SlenderN679/EP-CC_CC_Eolica/EP-CC_CC_Eólica/EP-CC_CC_Eólica.png

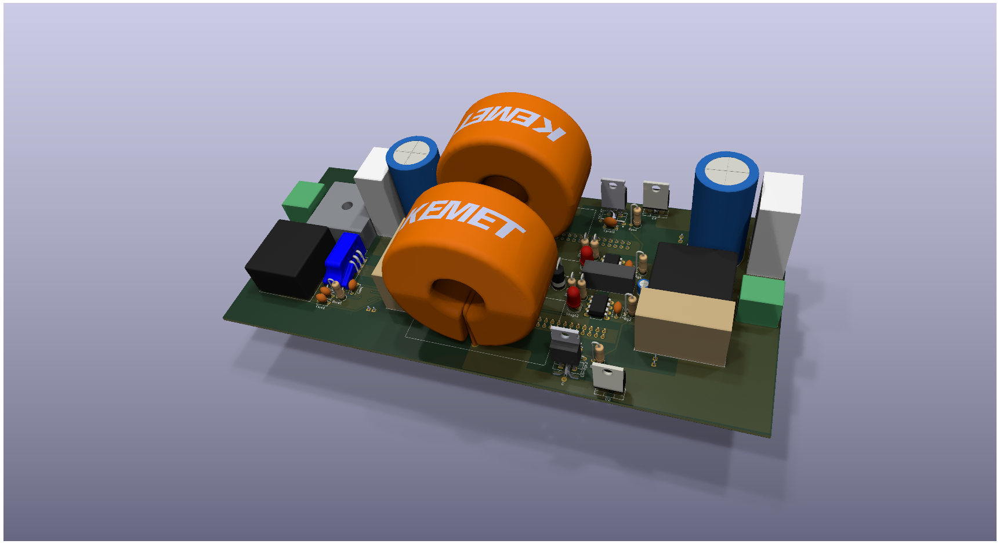
EP-CC_CC_Eólica/EP-CC_CC_Eólica.png
