SlenderN679/EP-CC_CC_Eolica/Lista_de_Componentes.xlsx

Reference | Value | Qty
Condensador eletrolítico pot. | 470uF 200V | 2
Condensador de filme pot. | 1.5uF 1.3KVDC | 2
Condensador eletrolítico | 1uF | 1
Condensador de ceramica | 47nF / 0.1uF / 10n | 7
Ponte retificadora trifásica | 600V 35A | 1
Díodo de potência | C3D10060A | 2
Leds de sinalização | 1.8V | 2
Díodo de Zener | 15 | 3
Conector | Lever Terminal Block | 3
Indutores | 311uH 15A | 2
Optocouplers | HCPL-3120 | 2
IGBT | 600V40A | 2
Resistências | 22 / 10k / 180 / 330 | 9
Resistências de descarga | 4.7k | 2
Sensor de corrente | HE/OL 25A | 1
STM32 | ~ | 1
Sensor de tensão | LV25-P | 2
Conversor CC-CC isolado | MEV1S1515SC | 1
