SlenderN679/EP-CC_CC_Eolica/EP-CC_CC_Eólica.csv

Reference | Qty | Value | Footprint | Datasheet
C1,C3 | 2 | 470uF 200V | Boost:CAP_22 X 35_NCH | LGU2D471MELZ
C2 | 1 | 1.5uF 1.3KVDC | Boost:CAP_B32774D1155K000_TDK | https://www.tdk-electronics.tdk.com/inf/20/20/db/fc_2009/MKP_B32774_778.pdf
C4 | 1 | 1.5UF 1.3KVDC | Boost:CAP_B32774D1155K000_TDK | https://www.tdk-electronics.tdk.com/inf/20/20/db/fc_2009/MKP_B32774_778.pdf
Cdc1 | 1 | 1uF | Capacitor_THT:CP_Radial_D5.0mm_P2.00mm | https://www.digikey.pt/en/products/detail/w%C3%BCrth-elektronik/860020672005/5727088
Cfilt1,Cref1,Cvcc1 | 3 | 47nF - Cer | Capacitor_THT:C_Disc_D5.1mm_W3.2mm_P5.00mm | https://www.digikey.pt/en/products/detail/kemet/C320C104K5R5TA/818040
Chcpl1,Chcpl2 | 2 | 0.1uF - Cer | Capacitor_THT:C_Disc_D5.1mm_W3.2mm_P5.00mm | https://www.digikey.pt/en/products/detail/kemet/C320C104K5R5TA/818040
Cprot1,Cprot2 | 2 | 10n | Capacitor_THT:C_Disc_D6.0mm_W2.5mm_P5.00mm
D1 | 1 | 600V 35A | Boost:VS-36MT160 | https://www.vishay.com/docs/93565/vs-36mtseries.pdf
D2,D3 | 2 | C3D10060A | PCM_Package_TO_SOT_THT_AKL:TO-220-2_Vertical_KA | https://www.tme.eu/Document/ee20f02f8d854de81dced643903ee11c/C3D08060A.pdf
Dhcpl1,Dhcpl2 | 2 | 1.8V | LED_THT:LED_D5.0mm | https://www.digikey.pt/en/products/detail/liteon/LTL2R3KRD-EM/2675133
DZ1 | 1 | D_Zener_Generic | Diode_THT:D_DO-27_P5.08mm_Vertical_AnodeUp | ~
DZprot1,DZprot2 | 2 | 15 | Diode_THT:D_DO-34_SOD68_P10.16mm_Horizontal | ~
J1 | 1 | Screw_Terminal_01x03 | Connector_Phoenix_SPT:PhoenixContact_SPT_2.5_3-H-5.0-EX_1x03_P5.0mm_Horizontal | ~
J2 | 1 | Screw_Terminal_01x02 | Connector_Phoenix_SPT:PhoenixContact_SPT_2.5_2-H-5.0-EX_1x02_P5.0mm_Horizontal | ~
JSource1 | 1 | Screw_Terminal_01x02 | Boost:CONN2_2604-3102_WAG | https://www.digikey.pt/en/products/detail/wago-corporation/2604-1101/15522416
L1,L2 | 2 | 311uH 15A | Boost:SHBC24W-2R1A0311V | https://yageogroup.com/content/datasheet/asset/file/KEM_LF0051_SHBC
OCiso1,OCiso2 | 2 | HCPL-3120 | PCM_Package_DIP_AKL:DIP-8_W7.62mm_LongPads | https://www.digikey.pt/en/products/detail/broadcom-limited/HCPL-3120/637386
Qbridge1,Qbridge2 | 2 | 600V40A | Boost:TO-220_High | https://www.tme.eu/Document/3d0f1152e66224fa282804db9c407ed3/STGW60V60DF.pdf
Rg1,Rg2 | 2 | 22 | Resistor_THT:R_Axial_DIN0309_L9.0mm_D3.2mm_P2.54mm_Vertical | https://www.digikey.pt/en/products/detail/stackpole-electronics-inc/CF14JT22R0/1741344
Rgs1,Rgs2,Rocd1 | 3 | 10k | Resistor_THT:R_Axial_DIN0309_L9.0mm_D3.2mm_P2.54mm_Vertical | https://www.digikey.pt/en/products/detail/stackpole-electronics-inc/CF12JT10K0/1741024,https://www.digikey.pt/en/products/detail/stackpole-electronics-inc/CFM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
Rhcpl1,Rhcpl2 | 2 | 180 | Resistor_THT:R_Axial_DIN0309_L9.0mm_D3.2mm_P2.54mm_Vertical | https://www.digikey.pt/en/products/detail/stackpole-electronics-inc/CF14JT180R/1741307
Rled1,Rled2 | 2 | 330 | Resistor_THT:R_Axial_DIN0309_L9.0mm_D3.2mm_P2.54mm_Vertical | https://www.digikey.pt/en/products/detail/stackpole-electronics-inc/CFM12JT330R/1741936
Rsafety1,Rsafety2 | 2 | 4.7k | Boost:TWM20J4K7E | https://www.ohmite.com/assets/images/res-tww-twm.pdf
S1 | 1 | HE/OL 25A | Boost:HO 25-N_SP33-1000 | https://www.lem.com/sites/default/files/products_datasheets/ho-np-sp33-1000-series-v7.pdf
STM1 | 1 | ~ | Boost:ST_Morpho_and_Zio_Connectors_144_STLink
U1,U2 | 2 | LV25-P | Sensor_Voltage:LEM_LV25-P | https://www.lem.com/sites/default/files/products_datasheets/lv_25-p.pdf
Upot1 | 1 | MEV1S1515SC | Library:MEV1S1505SC | https://www.digikey.pt/en/products/detail/murata-power-solutions-inc/MEV1S1515SC/2184911
