SlenderN679/EP-CC_CC_Eolica/EP-CC_CC_Eólica/Componentes/2604_3102 (1)/CadenasModel/2604-3102.igs

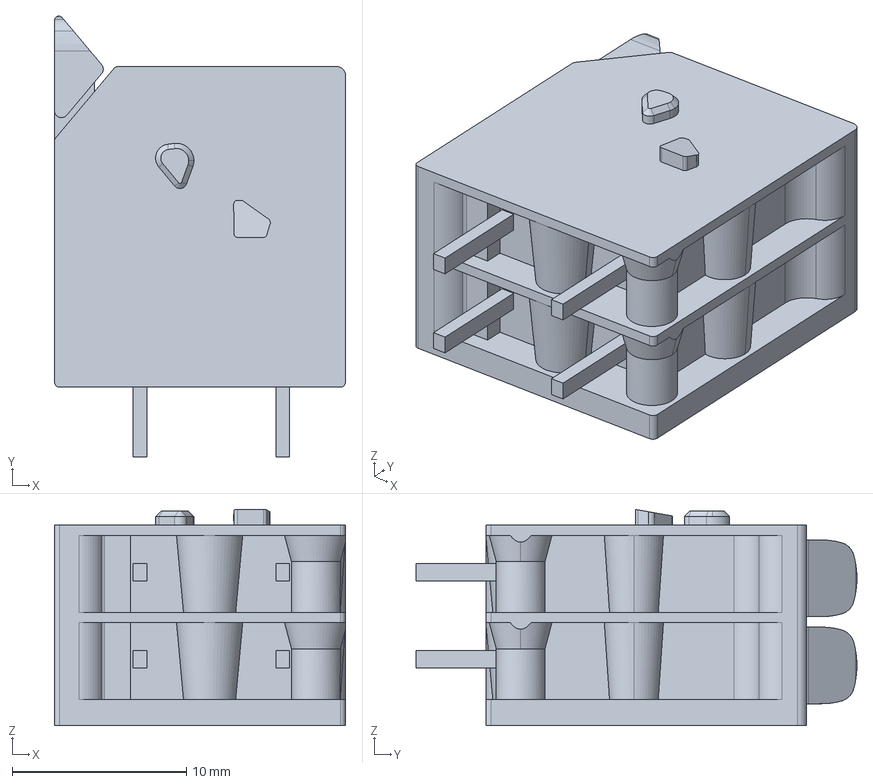
[picture p2: CAD file, 2026-10-19]
EP-CC_CC_Eólica/Componentes/2604_3102 (1)/CadenasModel/2604-3102.igs
16.7 x 25.3 x 12.4 mm
