SlenderN679/EP-CC_CC_Eolica/EP-CC_CC_Eólica/Componentes/64.50.19.033.0_20121120/HO_25-NP_SP33_blackbox/HO_25-NP_SP33_BLACKBOX.stp

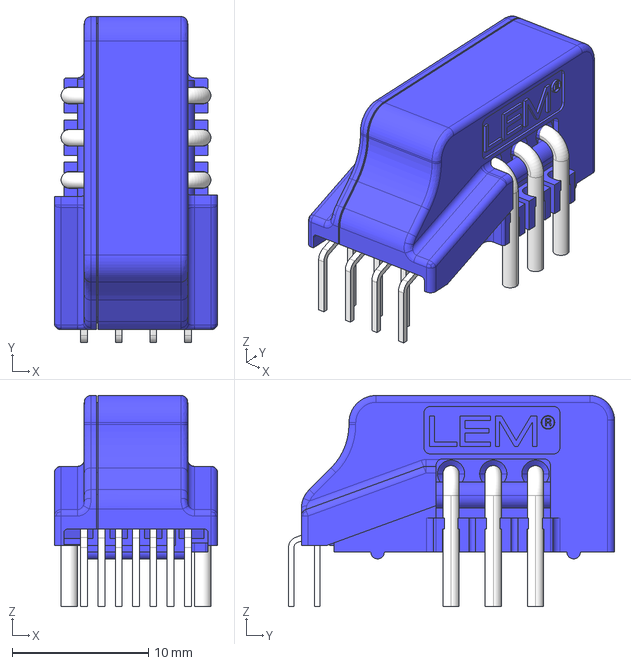
[picture p3: CAD file, 2026-10-19]
EP-CC_CC_Eólica/Componentes/64.50.19.033.0_20121120/HO_25-NP_SP33_blackbox/HO_25-NP_SP33_BLACKBOX.stp
12.0 x 23.9 x 15.5 mm
