SlenderN679/EP-CC_CC_Eolica/EP-CC_CC_Eólica/Componentes/90.27.19.000.0_20090128/LV25-P.stp

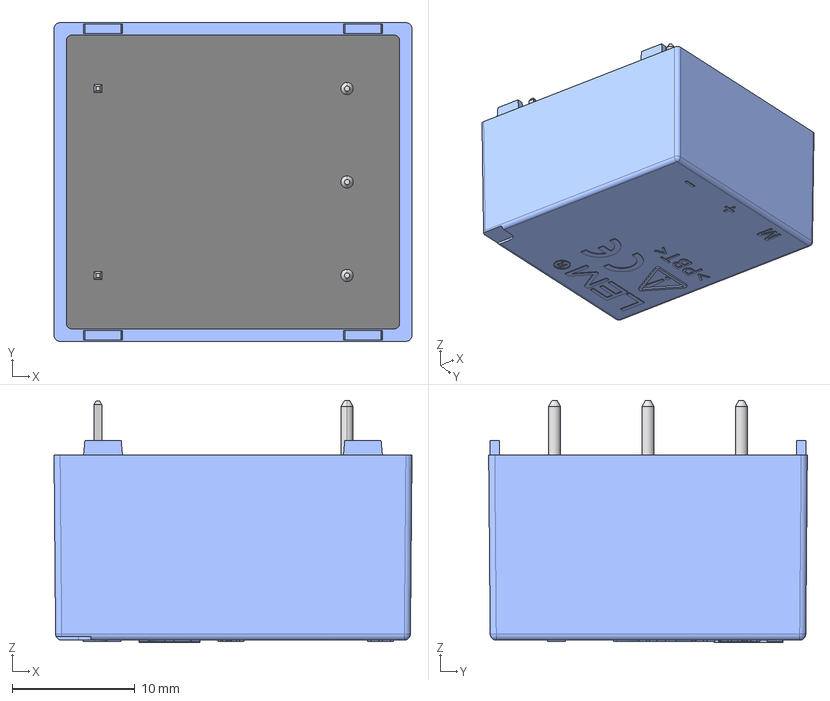
[picture p4: CAD file, 2026-09-29]
EP-CC_CC_Eólica/Componentes/90.27.19.000.0_20090128/LV25-P.stp
29.2 x 26.0 x 19.8 mm
boitier_blackbox
pin_mesure_Plus
pin_mesure_Moins
pin_mesure_M
pin_bobinage
pin_bobinage.1
moulage
