SlenderN679/EP-CC_CC_Eolica/EP-CC_CC_Eólica/Componentes/B32774D1155K000/CAP_B32774D1155K000_TDK.step

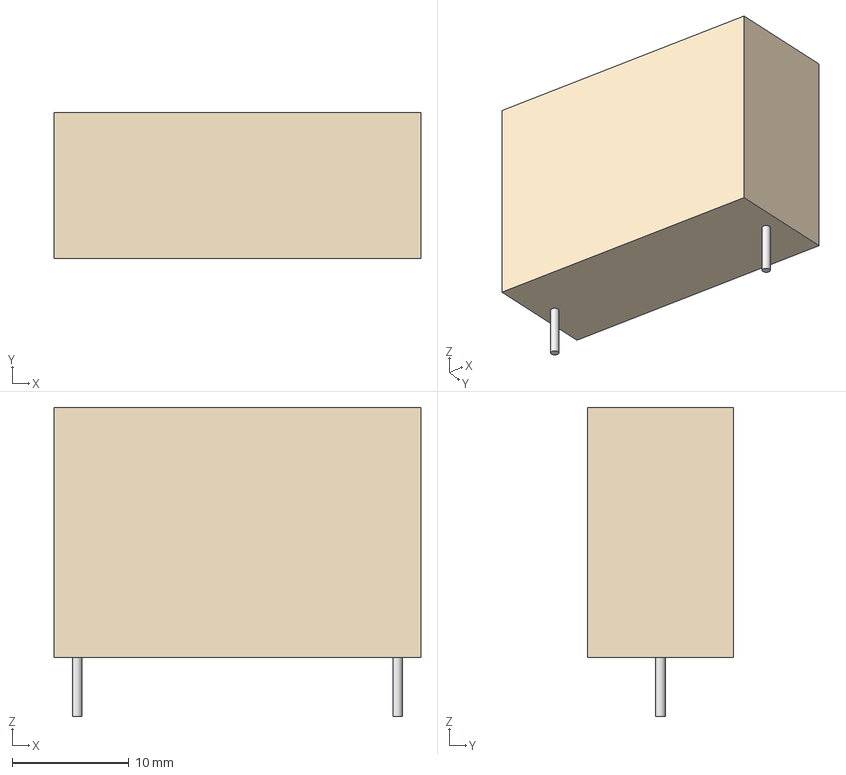
[picture p5: CAD file, 2026-09-29]
EP-CC_CC_Eólica/Componentes/B32774D1155K000/CAP_B32774D1155K000_TDK.step
31.5 x 12.5 x 26.5 mm
