SlenderN679/EP-CC_CC_Eolica/EP-CC_CC_Eólica/Componentes/C4D20120D/D Package Diode.step

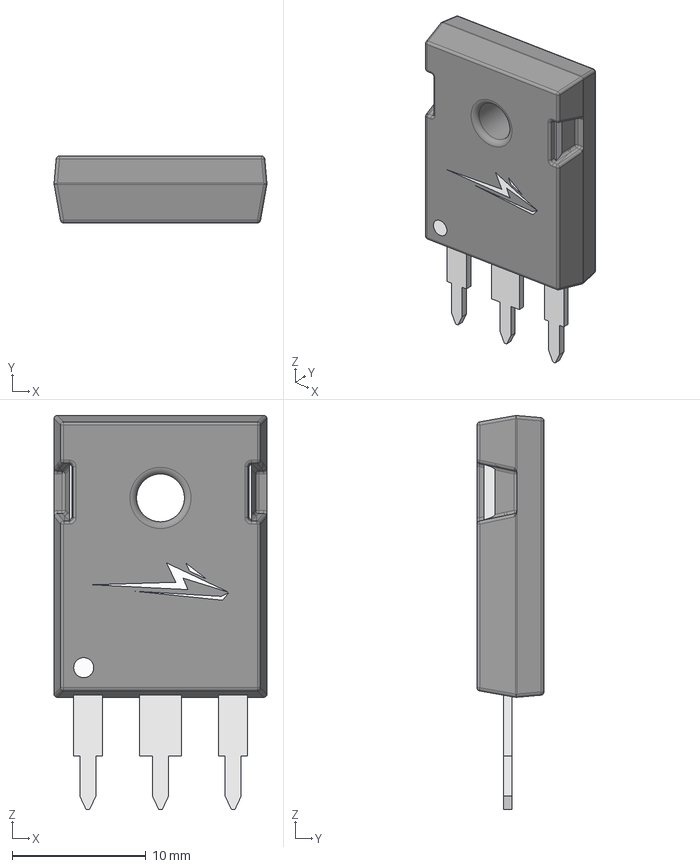
[picture p6: CAD file, 2026-09-29]
EP-CC_CC_Eólica/Componentes/C4D20120D/D Package Diode.step
15.9 x 5.02 x 29.5 mm
Pins
1.5mm
Wolfspeed Logo
Rear Tab
