SlenderN679/EP-CC_CC_Eolica/EP-CC_CC_Eólica/Componentes/IKW40N120H3FKSA1/PG-TO247-3-40.stp

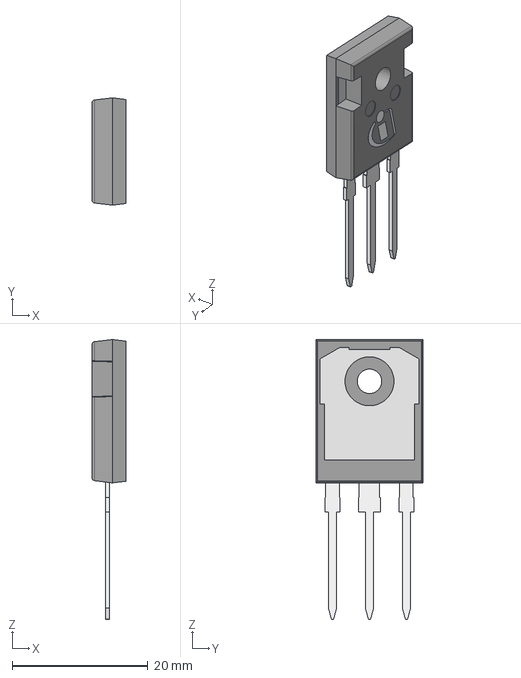
[picture p7: CAD file, 2026-09-29]
EP-CC_CC_Eólica/Componentes/IKW40N120H3FKSA1/PG-TO247-3-40.stp
5.01 x 15.8 x 41.2 mm
