SlenderN679/EP-CC_CC_Eolica/EP-CC_CC_Eólica/Componentes/PE_53117NL/PE-53117NL.STEP

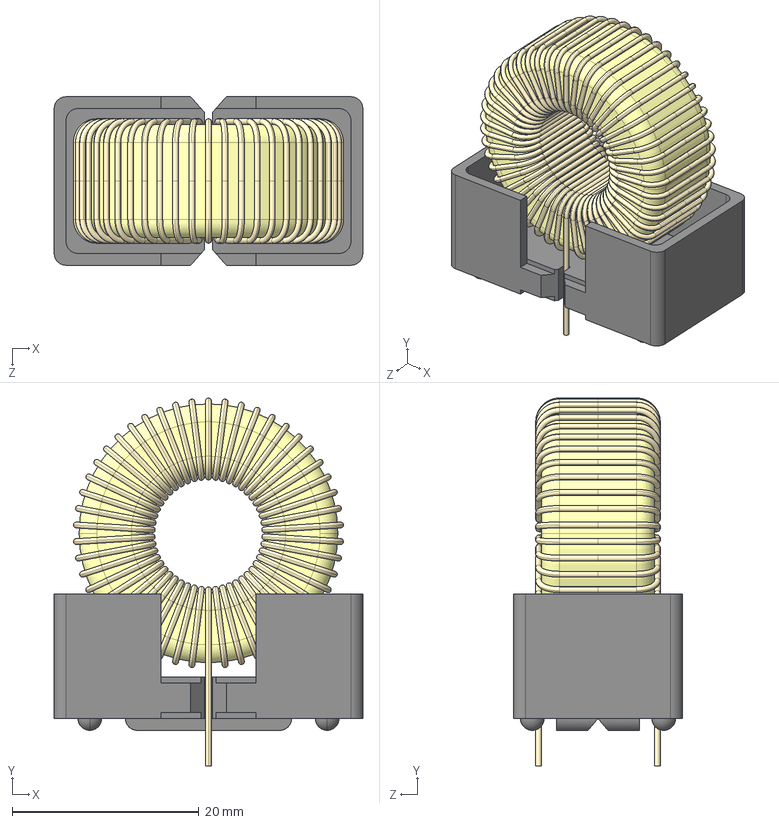
[picture p8: CAD file, 2026-10-19]
EP-CC_CC_Eólica/Componentes/PE_53117NL/PE-53117NL.STEP
33.0 x 39.4 x 18.0 mm
