SlenderN679/EP-CC_CC_Eolica/EP-CC_CC_Eólica/Componentes/ROX3SJ100K/RES_ROX3S_TYCO_TYC.step

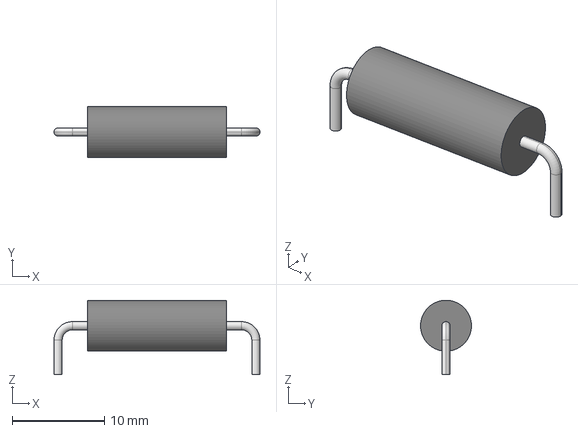
[picture p9: CAD file, 2026-09-29]
EP-CC_CC_Eólica/Componentes/ROX3SJ100K/RES_ROX3S_TYCO_TYC.step
22.3 x 5.51 x 8.05 mm
