SlenderN679/EP-CC_CC_Eolica/EP-CC_CC_Eólica/Componentes/STBR3012W/DO-247_STM.step

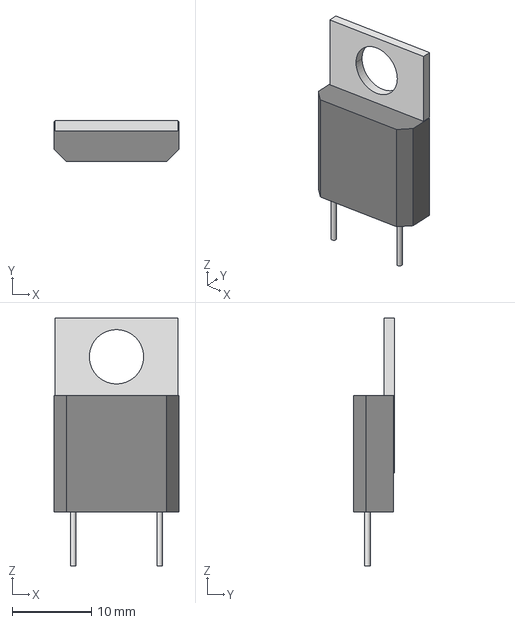
[picture p10: CAD file, 2026-09-29]
EP-CC_CC_Eólica/Componentes/STBR3012W/DO-247_STM.step
15.7 x 5.16 x 31.3 mm
