SlenderN679/EP-CC_CC_Eolica/EP-CC_CC_Eólica/Componentes/TO-220-Vert.STEP

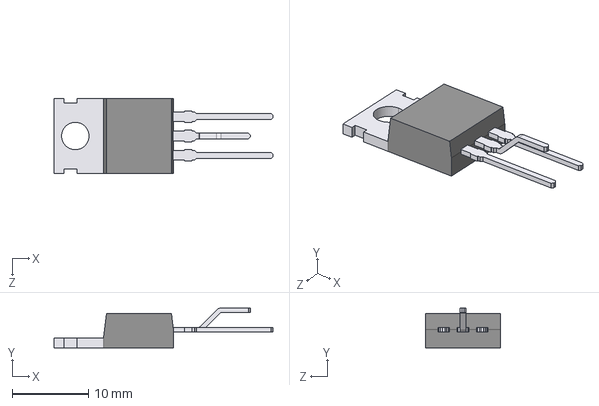
[picture p11: CAD file, 2026-10-19]
EP-CC_CC_Eólica/Componentes/TO-220-Vert.STEP
28.8 x 5.24 x 9.90 mm
