SlenderN679/EP-CC_CC_Eolica/EP-CC_CC_Eólica/Componentes/VM10_MVM10_stp.stp

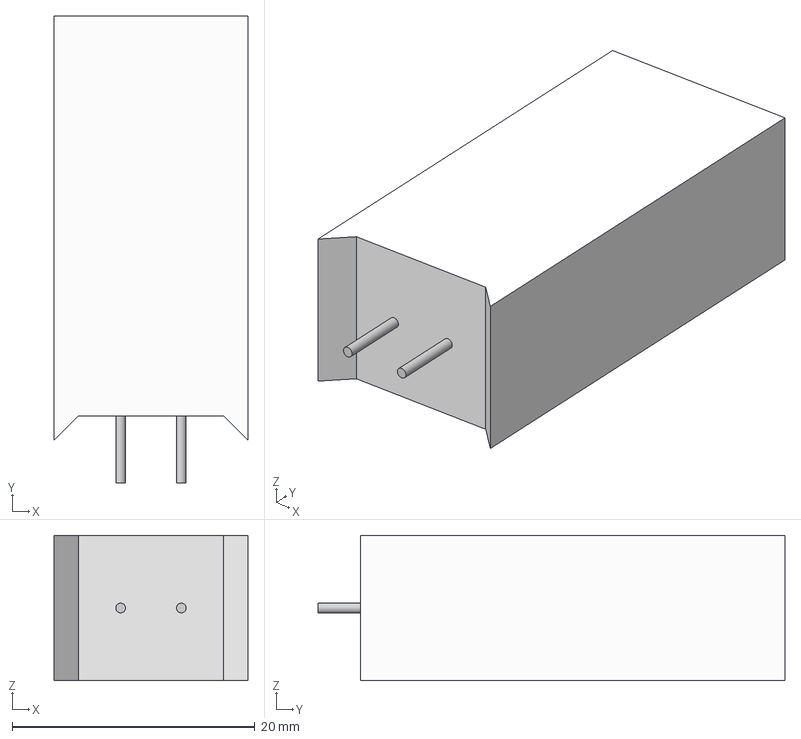
[picture p12: CAD file, 2026-10-19]
EP-CC_CC_Eólica/Componentes/VM10_MVM10_stp.stp
16.0 x 38.5 x 12.0 mm
