SlenderN679/EP-CC_CC_Eolica/EP-CC_CC_Eólica/Componentes/SHBC24W-2R1A0311V.step

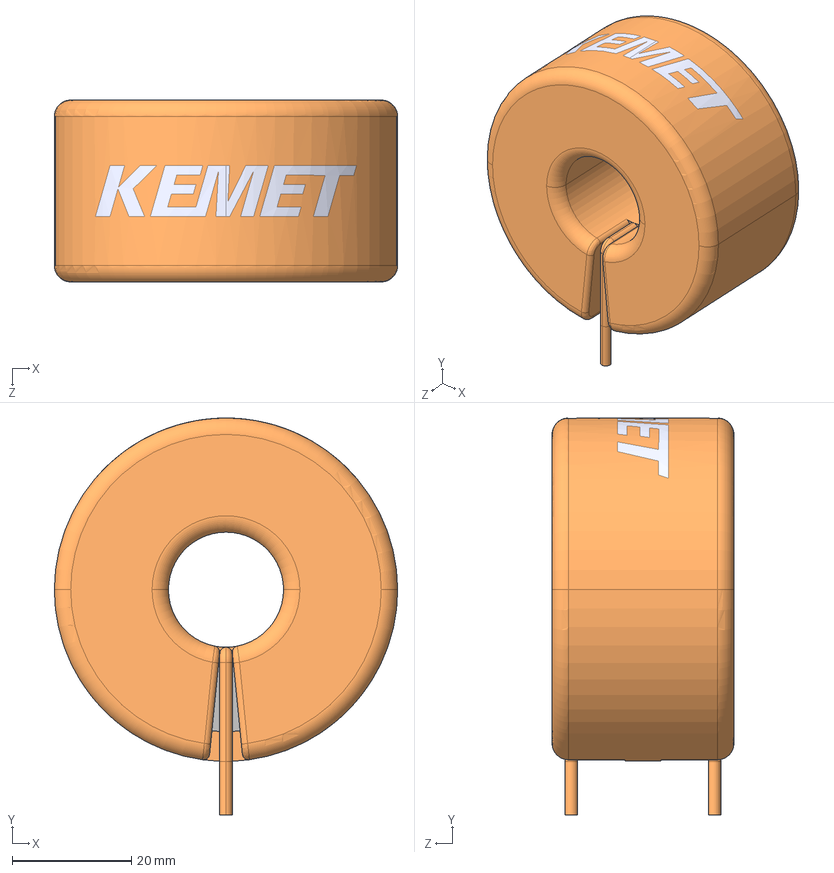
[picture p13: CAD file, 2026-10-19]
EP-CC_CC_Eólica/Componentes/SHBC24W-2R1A0311V.step
57.6 x 66.6 x 30.5 mm
