SlenderN679/EP-CC_CC_Eolica/EP-CC_CC_Eólica/Componentes/PPPC172LFBN-RC.STEP

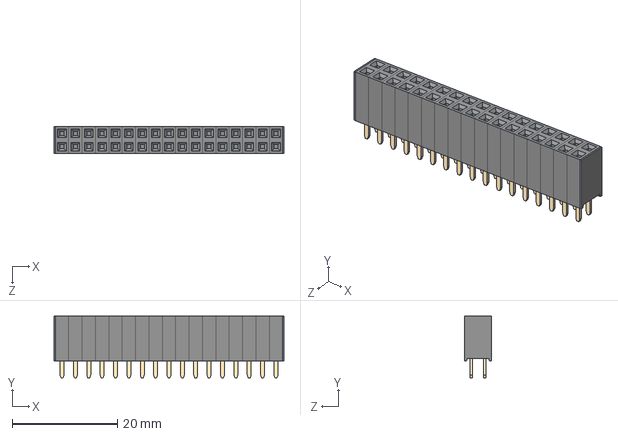
[picture p14: CAD file, 2026-09-29]
EP-CC_CC_Eólica/Componentes/PPPC172LFBN-RC.STEP
43.7 x 11.7 x 5.08 mm
NPPC202LFBN-RC_C17
Pin - Gold x 17
