SlenderN679/EP-CC_CC_Eolica/EP-CC_CC_Eólica/Componentes/PPPC082LFBN-RC.STEP

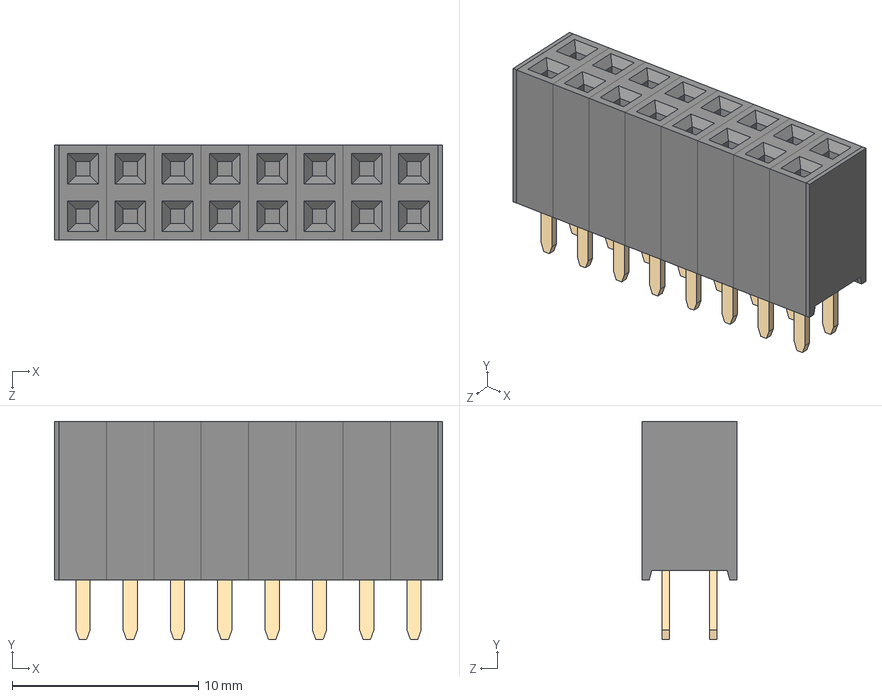
[picture p15: CAD file, 2026-09-29]
EP-CC_CC_Eólica/Componentes/PPPC082LFBN-RC.STEP
20.8 x 11.7 x 5.08 mm
NPPC202LFBN-RC_C08
Pin - Gold x 8
