SlenderN679/EP-CC_CC_Eolica/EP-CC_CC_Eólica/Componentes/NUCLEO-H755ZI-Q.STEP

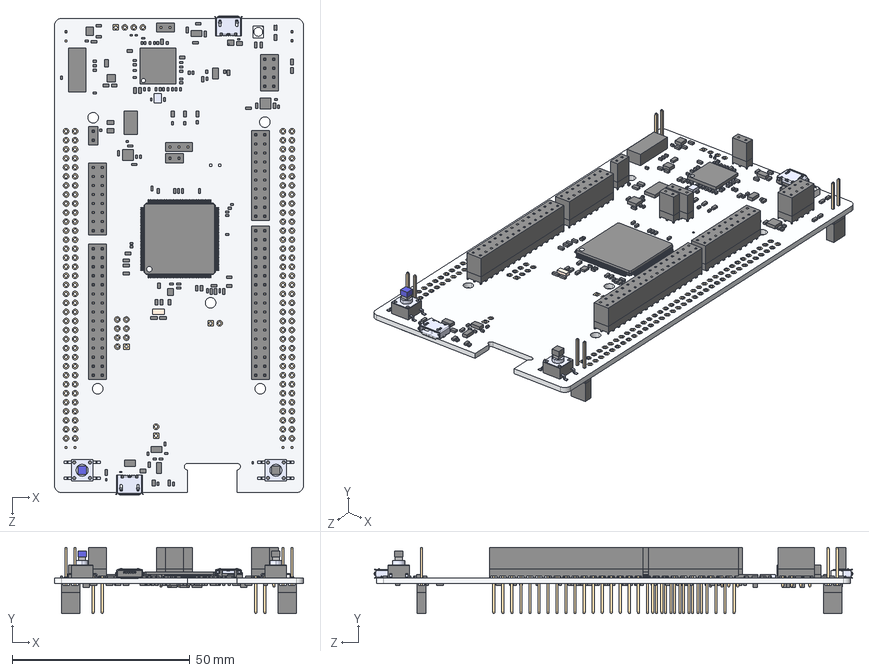
[picture p16: CAD file, 2026-09-29]
EP-CC_CC_Eólica/Componentes/NUCLEO-H755ZI-Q.STEP
70.0 x 18.6 x 134.5 mm
