SlenderN679/EP-CC_CC_Eolica/EP-CC_CC_Eólica/Componentes/PPTC021LFBN-RC.STEP

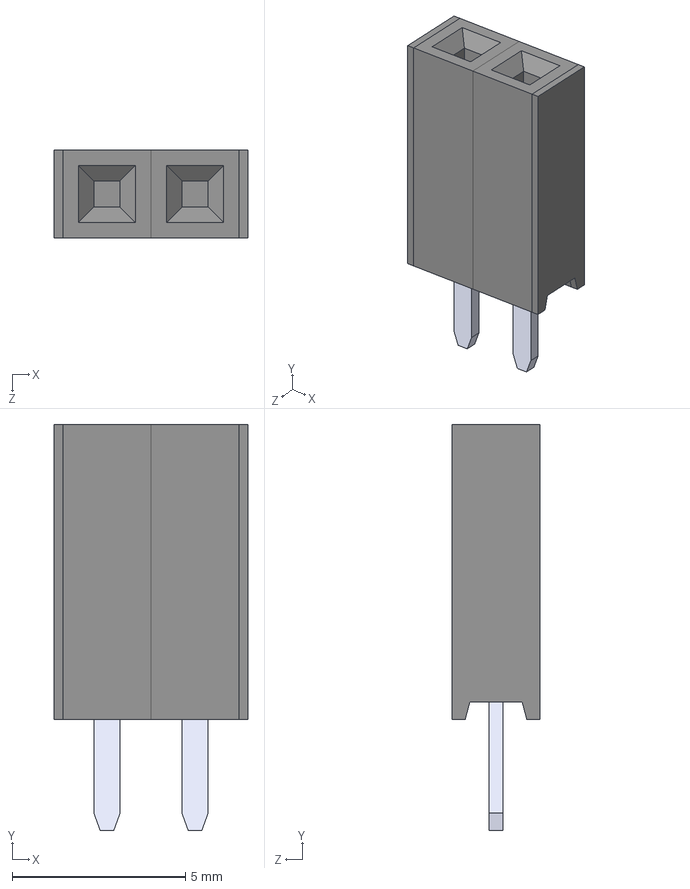
[picture p17: CAD file, 2026-09-29]
EP-CC_CC_Eólica/Componentes/PPTC021LFBN-RC.STEP
5.59 x 11.7 x 2.54 mm
PPPC021LFBN-RC_C02
Pin - Tin x 2
