SlenderN679/EP-CC_CC_Eolica/EP-CC_CC_Eólica/Componentes/61302021821.stp

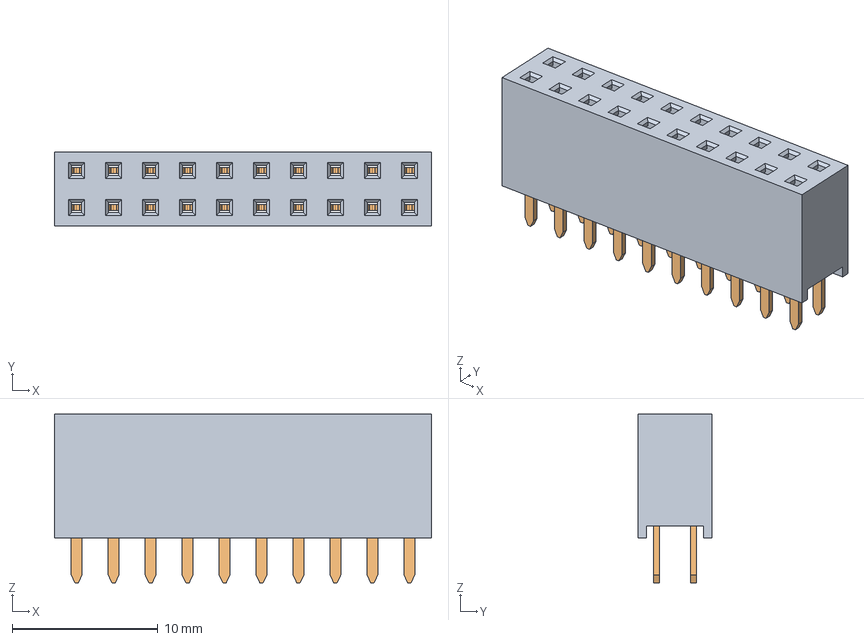
[picture p18: CAD file, 2026-09-29]
EP-CC_CC_Eólica/Componentes/61302021821.stp
25.9 x 5.08 x 11.6 mm
