SlenderN679/EP-CC_CC_Eolica/(list of files, cad)

Other CAD files:
EP-CC_CC_Eólica/Componentes/61300821821.stp
EP-CC_CC_Eólica/Componentes/61301021821.stp
EP-CC_CC_Eólica/Componentes/64.50.19.033.0_20121120/HO_25-NP_SP33_blackbox/HO_25-NP_SP33_BLACKBOX.igs
EP-CC_CC_Eólica/Componentes/90.27.19.000.0_20090128/LV25-P.igs
