SlenderN679/EP-CC_CC_Eolica/Simulation/26_10_19.pdf

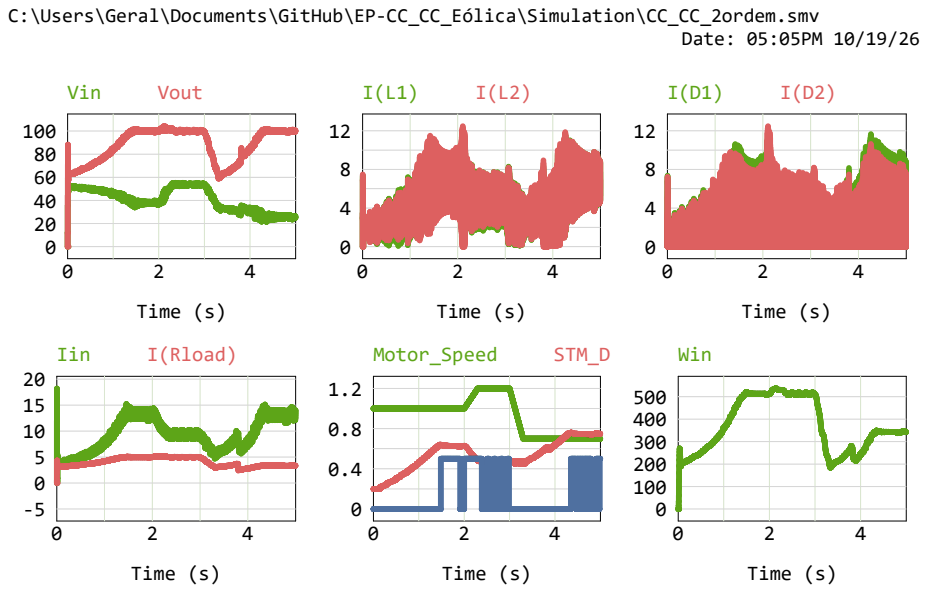
[picture p19: page 1]
Date: 05:05PM 10/19/26; Time (s); Vin; Vout; Iin; I(Rload); Motor_Speed; STM_D; STM_MODE; Win

C:\Users\Geral\Documents\GitHub\EP-CC_CC_Eólica\Simulation\CC_CC_2ordem.smv
