SlenderN679/EP-CC_CC_Eolica/Simulation/26_10_11.pdf

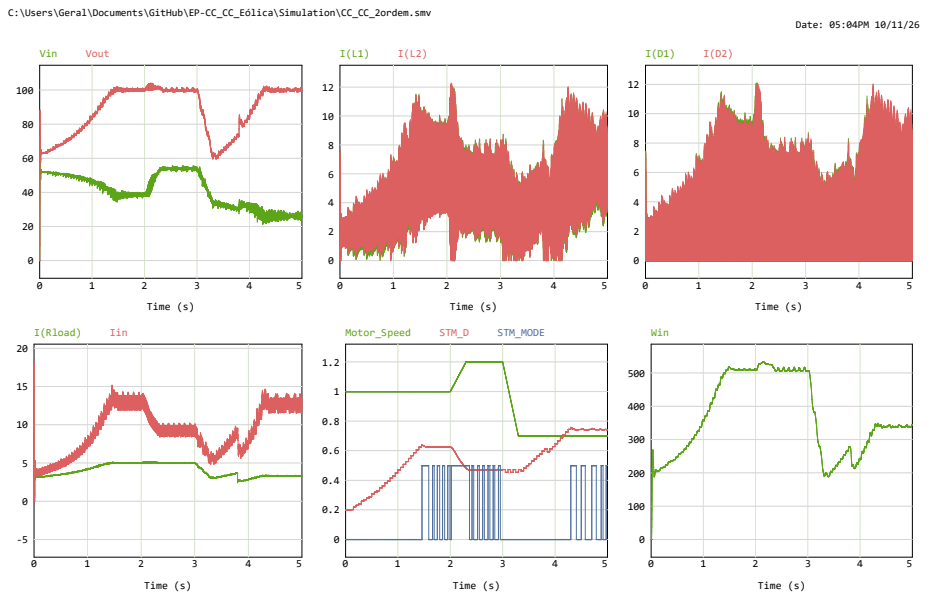
[picture p20: page 1]
Date: 05:04PM 10/11/26; Time (s); Vin; Vout; I(Rload); Iin; Motor_Speed; STM_D; STM_MODE; Win

C:\Users\Geral\Documents\GitHub\EP-CC_CC_Eólica\Simulation\CC_CC_2ordem.smv
