SlenderN679/EP-CC_CC_Eolica/Simulation/26_10_10.pdf

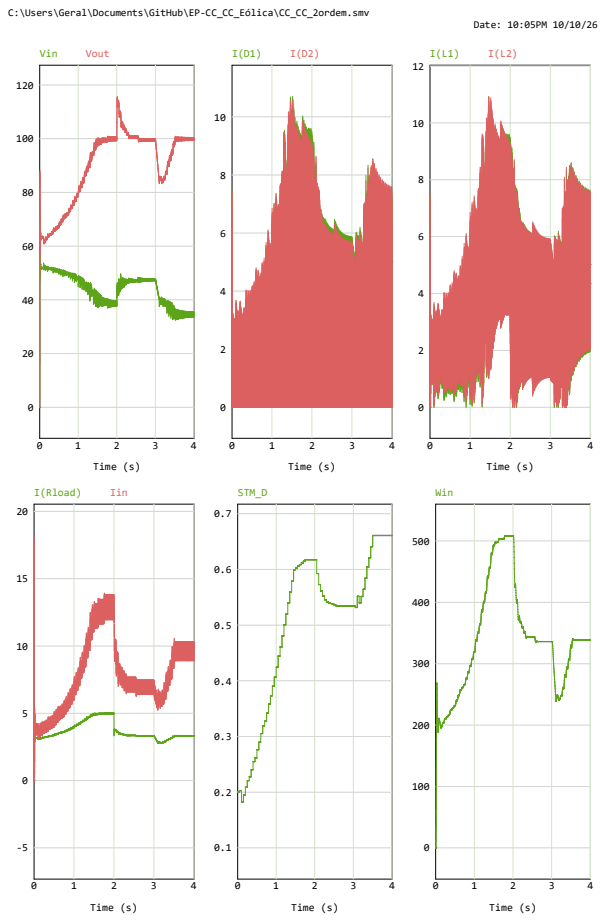
[picture p21: page 1]
Date: 10:05PM 10/10/26; Time (s); Vin; Vout; I(Rload); Iin; STM_D; Win

C:\Users\Geral\Documents\GitHub\EP-CC_CC_Eólica\CC_CC_2ordem.smv
