SlenderN679/EP-CC_CC_Eolica/Simulation/26_10_14_simp.pdf

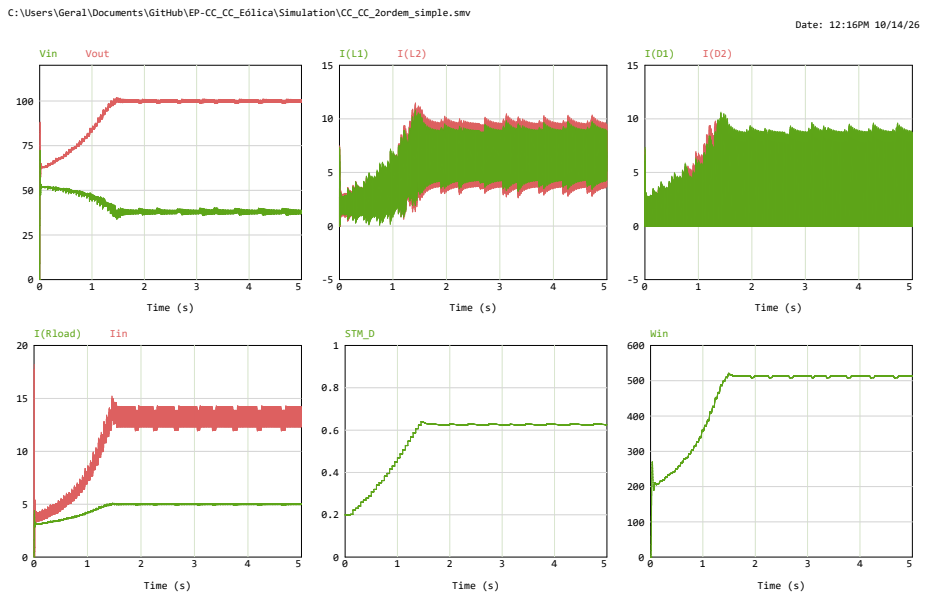
[picture p22: page 1]
Date: 12:16PM 10/14/26; Time (s); Vin; Vout; I(Rload); Iin; STM_D; Win

C:\Users\Geral\Documents\GitHub\EP-CC_CC_Eólica\Simulation\CC_CC_2ordem_simple.smv
