SlenderN679/EP-CC_CC_Eolica/(list of files, drawings)

Other design files:
EP-CC_CC_Eólica/Componentes/ul_IKW40N120H3FKSA1/Altium/IKW40N120H3.SchLib
EP-CC_CC_Eólica/Componentes/ul_IKW40N120H3FKSA1/Altium/INF-PG-TO247-3.PcbLib
