SlenderN679/EP-CC_CC_Eolica/EP-CC_CC_Eólica/EP-CC_CC_Eólica.kicad_pcb

## KiCad design EP-CC_CC_Eólica/EP-CC_CC_Eólica.kicad_pcb (2026-10-21)

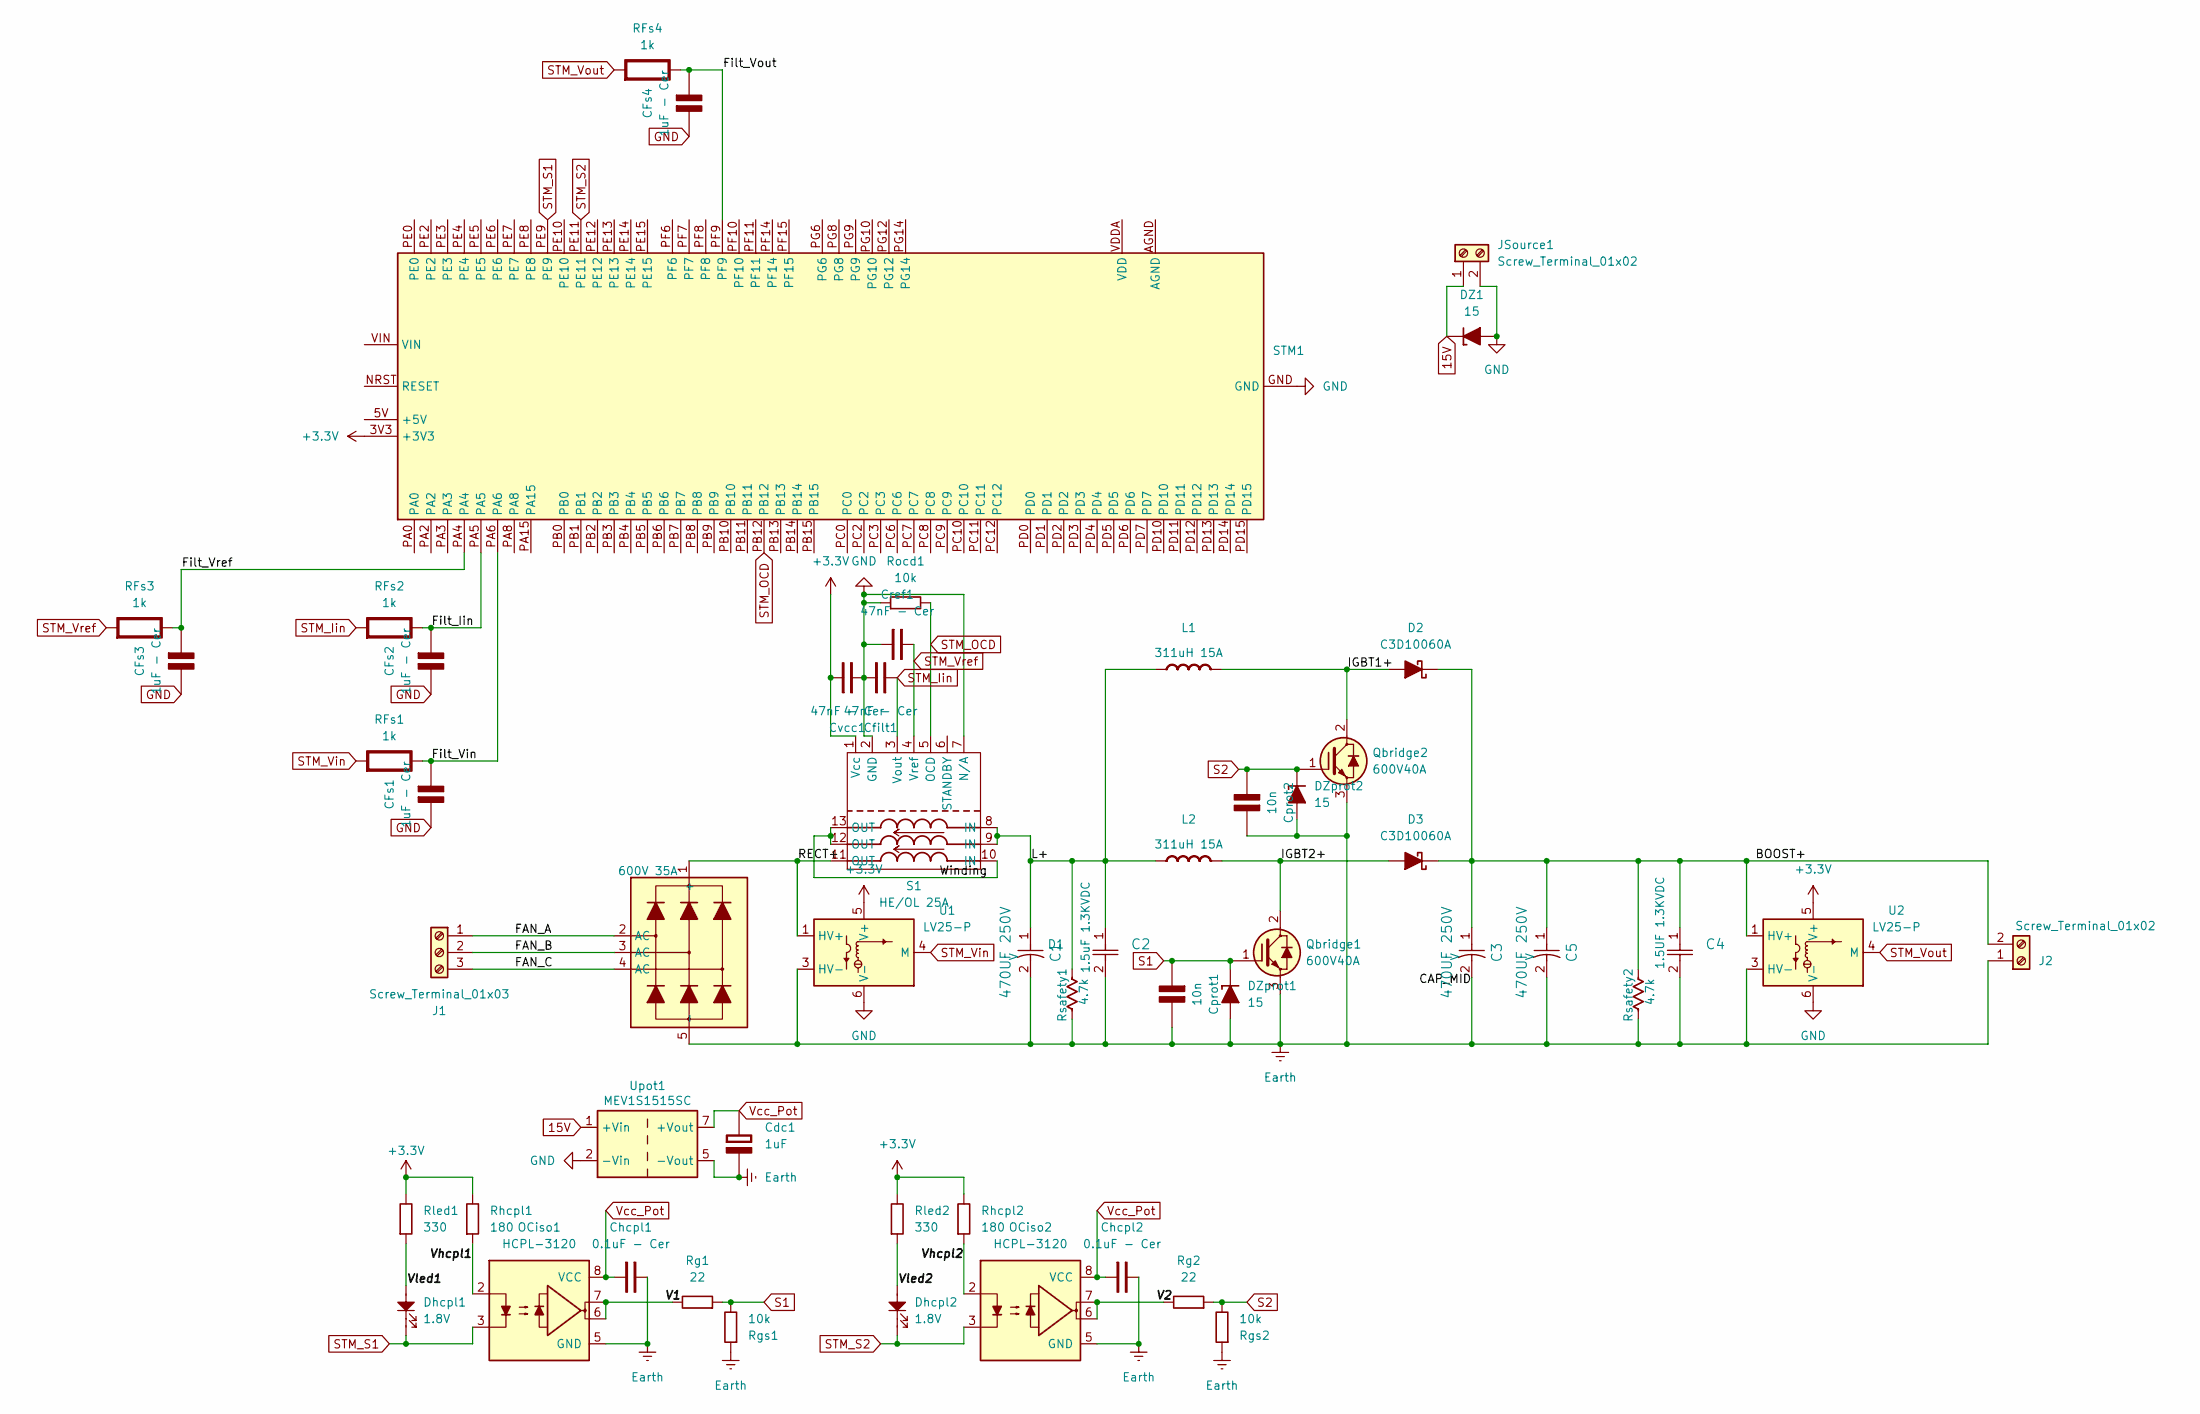
[picture p23: schematic EP-CC_CC_Eólica.kicad_sch]

Parts:
C1, C3, C5: 470UF 250V; LGW2E471MELZ40; Rating V
C2: 1.5uF 1.3KVDC; CAP_B32774D1155K000_TDK
C4: 1.5UF 1.3KVDC; CAP_B32774D1155K000_TDK
CFs1, CFs2, CFs3, CFs4: 1uF - Cer; C_Disc_D7.5mm_W4.4mm_P5.00mm; Rating V
Cdc1: 1uF; CP_Radial_D5.0mm_P2.00mm; Rating V
Cfilt1: 47nF - Cer; C_Disc_D5.1mm_W3.2mm_P5.00mm
Chcpl1, Chcpl2: 0.1uF - Cer; C_Disc_D5.1mm_W3.2mm_P5.00mm
Cprot1, Cprot2: 10n; C_Disc_D6.0mm_W2.5mm_P5.00mm; Rating V
Cref1: 47nF - Cer; C_Disc_D5.1mm_W3.2mm_P5.00mm
Cvcc1: 47nF - Cer; C_Disc_D5.1mm_W3.2mm_P5.00mm
D1: 600V 35A; VS-36MT160
D2, D3: C3D10060A; TO-220-2_Vertical_KA
DZ1: 15; D_DO-27_P5.08mm_Vertical_AnodeUp
DZprot1, DZprot2: 15; D_DO-34_SOD68_P10.16mm_Horizontal
Dhcpl1, Dhcpl2: 1.8V; LED_D5.0mm
J1: Screw_Terminal_01x03; PhoenixContact_SPT_2.5_3-H-5.0-EX_1x03_P5.0mm_Horizontal
J2: Screw_Terminal_01x02; PhoenixContact_SPT_2.5_2-H-5.0-EX_1x02_P5.0mm_Horizontal
JSource1: Screw_Terminal_01x02; CONN2_2604-3102_WAG
L1, L2: 311uH 15A; SHBC24W-2R1A0311V; Rating A
OCiso1, OCiso2: HCPL-3120; DIP-8_W7.62mm_LongPads
Qbridge1, Qbridge2: 600V40A; TO-220_High
RFs1, RFs2, RFs3, RFs4: 1k; R_Axial_DIN0309_L9.0mm_D3.2mm_P2.54mm_Vertical; Rating W
Rg1, Rg2: 22; R_Axial_DIN0309_L9.0mm_D3.2mm_P2.54mm_Vertical
Rgs1, Rgs2: 10k; R_Axial_DIN0309_L9.0mm_D3.2mm_P2.54mm_Vertical
Rhcpl1, Rhcpl2: 180; R_Axial_DIN0309_L9.0mm_D3.2mm_P2.54mm_Vertical
Rled1, Rled2: 330; R_Axial_DIN0309_L9.0mm_D3.2mm_P2.54mm_Vertical
Rocd1: 10k; R_Axial_DIN0309_L9.0mm_D3.2mm_P2.54mm_Vertical
Rsafety1, Rsafety2: 4.7k; TWM20J4K7E
S1: HE/OL 25A; HO 25-N_SP33-1000
STM1: ST_Morpho_and_Zio_Connectors_144_STLink
U1, U2: LV25-P; LEM_LV25-P
Upot1: MEV1S1515SC; MEV1S1505SC

Connections:
15V: DZ1.1 (K), JSource1.1, Upot1.1 (+Vin)
+3.3V: Cvcc1.2, Rhcpl1.2, Rhcpl2.2, Rled1.2, Rled2.2, S1.1 (Vcc), STM1.3V3 (+3V3), U1.5 (V+), U2.5 (V+)
/BOOST+: C3.1, C4.1, C5.1, D2.1 (K), D3.1 (K), J2.2, Rsafety2.1, U2.1 (HV+)
/FAN_A: D1.2 (AC), J1.1
/FAN_B: D1.3 (AC), J1.2
/FAN_C: D1.4 (AC), J1.3
/Filt_Iin: CFs2.1 (+), RFs2.1 (+), STM1.PA5
/Filt_Vin: CFs1.1 (+), RFs1.1 (+), STM1.PA6
/Filt_Vout: CFs4.1 (+), RFs4.1 (+), STM1.PF9
/Filt_Vref: CFs3.1 (+), RFs3.1 (+), STM1.PA4
/IGBT1+: D2.2 (A), L1.2 (-), Qbridge2.2 (C)
/IGBT2+: D3.2 (A), L2.2 (-), Qbridge1.2 (C)
/L+: C1.1, C2.1, L1.1 (+), L2.1 (+), Rsafety1.1, S1.8 (IN), S1.9 (IN)
/RECT+: D1.1 (+), S1.11 (OUT), U1.1 (HV+)
/V1: OCiso1.6, OCiso1.7, Rg1.2
/V2: OCiso2.6, OCiso2.7, Rg2.2
/Vhcpl1: OCiso1.2, Rhcpl1.1
/Vhcpl2: OCiso2.2, Rhcpl2.1
/Vled1: Dhcpl1.2, Rled1.1
/Vled2: Dhcpl2.2, Rled2.1
/Winding: S1.10 (IN), S1.12 (OUT), S1.13 (OUT)
Earth: C1.2, C2.2, C3.2, C4.2, C5.2, Cdc1.2 (-), Chcpl1.2, Chcpl2.2, Cprot1.2 (-), Cprot2.2 (-), D1.5 (-), DZprot1.2 (A), DZprot2.2 (A), J2.1, OCiso1.5 (GND), OCiso2.5 (GND), Qbridge1.3 (E), Qbridge2.3 (E), Rgs1.1, Rgs2.1, Rsafety1.2, Rsafety2.2, U1.3 (HV-), U2.3 (HV-), Upot1.5 (-Vout)
GND: CFs1.2 (-), CFs2.2 (-), CFs3.2 (-), CFs4.2 (-), Cfilt1.2, Cref1.2, Cvcc1.1, DZ1.2 (A), JSource1.2, Rocd1.1, S1.2 (GND), S1.7 (N/A), STM1.GND, U1.6 (V-), U2.6 (V-), Upot1.2 (-Vin)
S1: Cprot1.1 (+), DZprot1.1 (K), Qbridge1.1 (G), Rg1.1, Rgs1.2
S2: Cprot2.1 (+), DZprot2.1 (K), Qbridge2.1 (G), Rg2.1, Rgs2.2
STM_Iin: Cfilt1.1, RFs2.2 (-), S1.3 (Vout)
STM_OCD: Rocd1.2, S1.5 (OCD), STM1.PB12
STM_S1: Dhcpl1.1, OCiso1.3, STM1.PE9
STM_S2: Dhcpl2.1, OCiso2.3, STM1.PE11
STM_Vin: RFs1.2 (-), U1.4 (M)
STM_Vout: RFs4.2 (-), U2.4 (M)
STM_Vref: Cref1.1, RFs3.2 (-), S1.4 (Vref)
Vcc_Pot: Cdc1.1 (+), Chcpl1.1, Chcpl2.1, OCiso1.8 (VCC), OCiso2.8 (VCC), Upot1.7 (+Vout)

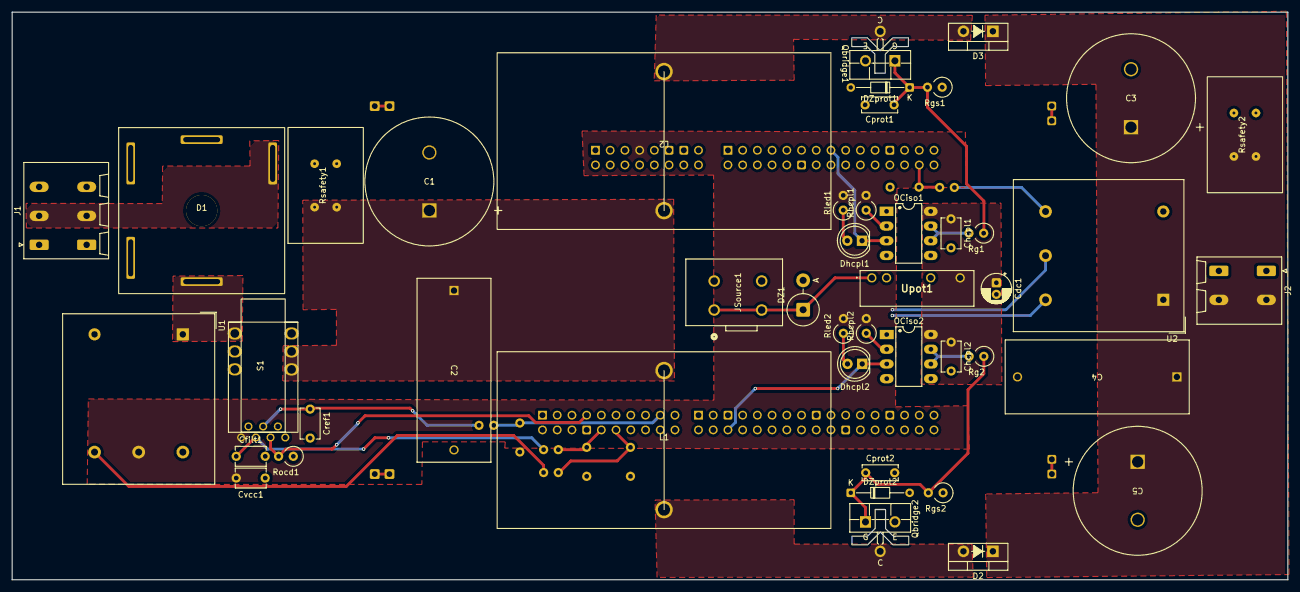
[picture p24: board EP-CC_CC_Eólica.kicad_pcb from above]

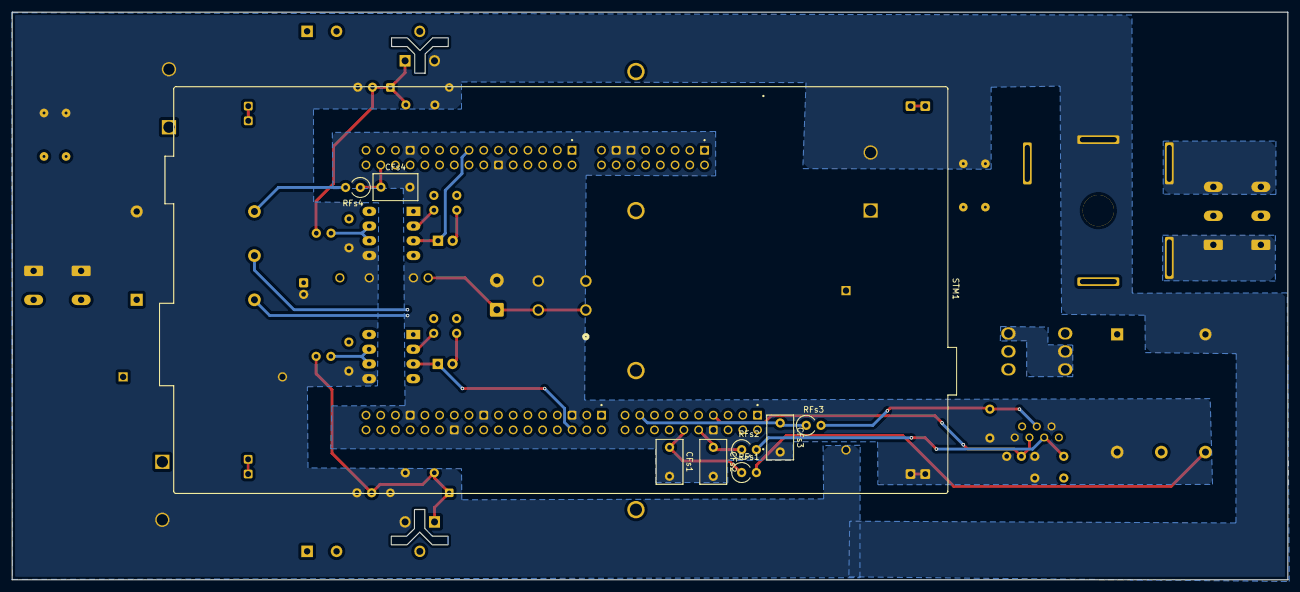
[picture p25: board EP-CC_CC_Eólica.kicad_pcb from below]

Board: 2 copper layers, 220.1 x 98.0 mm, 54 parts (9 on the bottom side), 33 nets.
