SlenderN679/EP-CC_CC_Eolica/Simulation/STM_TIM.cpp

#include <Stdlib.h>
#include <String.h>
#include <math.h>
#include <Psim.h>

// Variáveis Globais do Temporizador
double f_sw = 20000.0; // Frequência de comutação do STM32 (20 kHz)
double T_sw = 0.00005;

/////////////////////////////////////////////////////////////////////
// FUNCTION: SimulationStep
void SimulationStep(
		double t, double delt, double *in, double *out,
		 int *pnError, char * szErrorMsg,
		 void ** reserved_UserData, int reserved_ThreadIndex, void * reserved_AppPtr)
{
    // in[0] recebe o Duty Cycle (0.0 a 1.0) do bloco C do MPPT
    double D = in[0]; 
    
    // Limite de segurança (semelhante a limitar o registo CCR no STM32)
    if (D > 0.85) D = 0.85;
    if (D < 0.0) D = 0.0;

    // 1. Simulação do Registo CNT (Counter) do STM32
    // A função fmod() cria uma onda "dente de serra" que vai de 0 a 1 (Edge-Aligned PWM)
    double cnt_fase1 = fmod(t, T_sw) / T_sw;
    
    // Para a Fase 2 (Interleaved), adicionamos metade do período (180 graus de desfasamento)
    double cnt_fase2 = fmod(t + (T_sw / 2.0), T_sw) / T_sw;

    // 2. Simulação do Registo CCR (Capture/Compare) do STM32
    // Fase 1 - Saída para o IGBT 1 (TIM1_CH1)
    // Center-aligned counter: 0 -> 1 -> 0 over one period (counts up then down)
	// Note: in real center-aligned mode the PWM frequency is f_tim / (2*ARR)
	double ph  = fmod(t, T_sw) / T_sw;
	double tri = 1.0 - fabs(2.0 * ph - 1.0);
	
	// CH1: PWM mode 1, CCR1 = D      -> pulse centered on the valley
	out[0] = (tri < D) ? 1.0 : 0.0;
	
	// CH2: PWM mode 2, CCR2 = 1 - D  -> pulse centered on the peak (180° shifted)
	out[1] = (tri > 1.0 - D) ? 1.0 : 0.0;
}

/////////////////////////////////////////////////////////////////////
// FUNCTION: SimulationBegin
void SimulationBegin(
		const char *szId, int nInputCount, int nOutputCount,
		 int nParameterCount, const char ** pszParameters,
		 int *pnError, char * szErrorMsg,
		 void ** reserved_UserData, int reserved_ThreadIndex, void * reserved_AppPtr)
{
    // Calcula o período da onda com base na frequência definida
    T_sw = 1.0 / f_sw;
}

/////////////////////////////////////////////////////////////////////
// FUNCTION: SimulationEnd
void SimulationEnd(const char *szId, void ** reserved_UserData, int reserved_ThreadIndex, void * reserved_AppPtr)
{
}
