SlenderN679/EP-CC_CC_Eolica/Simulation/TEST.cpp

#include <Stdlib.h>
#include <String.h>
#include <math.h>
#include <Psim.h>

/////////////////////////////////////////////////////////////////////
// TEST PROFILE - drives the disturbances during the simulation
//
// Outputs: out[0], out[1], out[2] = phase voltages Va, Vb, Vc  [V]
//                                   -> 3 voltage-controlled voltage sources (gain 1)
//          out[3]                 = load switch gate (1 = closed)
//                                   -> on-off controller -> switch across R_extra
//
// Sequence (edit below):
//   0 .. 2 s : 45 V L-L rms, Rload = 20 ohm
//   2 s      : load step 20 -> 30 ohm (switch opens, R_extra = 10 ohm in series)
//   3 s      : source ramps 45 -> 38 V L-L rms over 0.1 s
/////////////////////////////////////////////////////////////////////

static const double PI      = 3.14159265358979;
static const double F_GRID  = 50.0;   // source frequency [Hz]

static const double VLL_1   = 45.0;   // initial line-line rms voltage [V]
static const double VLL_2   = 38.0;   // final line-line rms voltage [V]
static const double T_VSTEP = 3.0;    // start of voltage change [s]
static const double T_RAMP  = 0.1;    // ramp duration (0 = hard step) [s]

static const double T_LSTEP = 2.0;    // load step time [s]

void SimulationStep(
		double t, double delt, double *in, double *out,
		 int *pnError, char * szErrorMsg,
		 void ** reserved_UserData, int reserved_ThreadIndex, void * reserved_AppPtr)
{
    // Line-line rms voltage profile (step or linear ramp)
    double VLL;
    if (t < T_VSTEP)                 VLL = VLL_1;
    else if (t < T_VSTEP + T_RAMP)   VLL = VLL_1 + (VLL_2 - VLL_1) * (t - T_VSTEP) / T_RAMP;
    else                             VLL = VLL_2;

    double Vpk = VLL * sqrt(2.0 / 3.0);   // phase peak voltage
    double wt  = 2.0 * PI * F_GRID * t;

    out[0] = Vpk * sin(wt);
    out[1] = Vpk * sin(wt - 2.0 * PI / 3.0);
    out[2] = Vpk * sin(wt + 2.0 * PI / 3.0);

    // Load: switch closed (R_extra shorted) before T_LSTEP, open after
    out[3] = (t < T_LSTEP) ? 1.0 : 0.0;
}

void SimulationBegin(
		const char *szId, int nInputCount, int nOutputCount,
		 int nParameterCount, const char ** pszParameters,
		 int *pnError, char * szErrorMsg,
		 void ** reserved_UserData, int reserved_ThreadIndex, void * reserved_AppPtr)
{
}

void SimulationEnd(const char *szId, void ** reserved_UserData, int reserved_ThreadIndex, void * reserved_AppPtr)
{
}
