SlenderN679/EP-CC_CC_Eolica/(notices)

Notices in the files:
EP-CC_CC_Eólica/Componentes/2604_3102 (1)/CadenasModel/2604-3102.igs:
Data from Parasolid IGES Translator 28.1.247, Copyright(c) 2006 Siemens S 1
PLM Software. All Rights Reserved. S 2
